zoujq/1025--/电路/电路设计.docx

耀贵电子-风扇

引脚 | 功能 | 分配 | 备注注意事项
1 | TK15/P1.7 | TOUCH1 | 开关
2 | TK14/P1.6 | TOUCH2 | 风速
3 | TK13/P1.5 | TOUCH3 | 摇头
4 | TK12/P1.4 | TOUCH4 | 定时
5 | TK11/P1.3 | DW1 | 可控硅1挡驱动
6 | TK10/P1.2 | DW2 | 可控硅2挡驱动
7 | TK9/P1.1 | DW3 | 可控硅3挡驱动
8 | Vref/AN7/P0.7 | YAOTOU | 可控硅摇头驱动
9 | GND
10 | VDD
11 | P0.3/AN3/TK3 | UART_RX | wifi RX
12 | P0.2/AN2/TK2 | UART_TX | wifi TX
13 | P0.1/AN1/TK1/INT1 | C | 数码管
14 | P0.0/AN0/TK0/INT0/FLT0 | D | 数码管
15 | P2.7/AN15 | E | 数码管
16 | P2.6/AN14 | F | 数码管
17 | P2.5/AN13 | G | 数码管
18 | P2.4/AN12/RST | BUZZ
19 | P3.5/INT17 | NEC_R | 红外接收
20 | P3.4/INT16 | COM1 | 数码管
21 | P2.3/AN11 | COM2 | 数码管
22 | P2.2/AN10/SCK | TOUCH_LED_COM | 触摸灯
23 | P2.1/AN9 | A | 数码管
24 | P2.0/NA8/SDA | B | 数码管
