zoujq/1025--/电路/1025-风扇/1025-风扇BOM.xls

Comment | Description | Designator | Footprint | Quantity | Value
Cap | Polarized Capacitor (Radial) | C2, C3 | CAE8-3.05 | 2 | 2.2uF/400V
Cap | Capacitor | C5 | C 1206_M | 1 | 10uF
Cap | Polarized Capacitor (Radial) | C6 | CAE8-3.05 | 1 | 470uF/16V
Cap | Capacitor | C10 | C 0805_L | 1 | 10uF
Cap | Capacitor | C11 | C 0603_L | 1 | 0.1uF
安规电容 | 安规Capacitor | CX1 | CX2-13*5-10 | 1 | 0.22uF
M7 | 整流二极管 | D1, D2 | D3528 | 2
ES1J | 快速二极管 | D3 | D3528 | 1
LED0 | Typical INFRARED GaAs LED | D10, D11, D12, D13 | LED 0805W | 4
Fuse 1 | Fuse | F2 | FUSE15 | 1
TOUCH | 触摸弹簧 | KEY1, KEY2, KEY3, KEY4 | KEY-T9-2 | 4
Inductor | Inductor | L1 | L15 | 1 | 1mH
Inductor | Inductor | L2 | L3 | 1 | 1mH
Speaker | Loudspeaker | LS1 | BEEP 4x9x5.5 | 1
JSI838 | 红外接收器 | NEC2 | HS0038B | 1
220V~ | Header, 2-Pin | P00 | VH-3AW | 1
档位接口 | Header, 4-Pin | P01 | XH-4AW | 1
主板电源接口 | Header, 6-Pin | P50 | HDR1.27-LI-6P | 1
电源板电源接口 | Header, 6-Pin | P51 | HDR1.27-M-LI-6P | 1
HST97A8 | Silicon Bidirectional Triode Thyristor | Q1, Q2, Q3, Q4 | SOT-89 | 4
10D471 | Varistor (Voltage-Sensitive Resistor) | R1 | ZNR7.5 | 1
Res2 | Resistor | R2 | R 1206-HP_M | 1 | 24K
Res2 | Resistor | R3 | R 1206-HP_M | 1 | 1K
Res2 | Resistor | R6 | R 1206-HP_M | 1 | 22K
Res2 | Resistor | R8 | R 1206-HP_M | 1 | 510K
Res2 | Resistor | R10, R11, R12, R13, R14, R15, R16 | R 0603_L | 7 | 201
Res2 | Resistor | R20, R21, R22, R23 | R 1206-HP_M | 4 | 561
Res2 | Resistor | R30 | R 0603_L | 1 | 1K
Res2 | Resistor | R50 | R 0603_L | 1 | 4.7K
3621A | 0.36寸2位共阴数码管 | SMG1 | SMG 0.36-2P | 1
YX23F01CB_24 | 主控MCU | U1 | SOP24_M | 1
LP2601 | 5V隔离电源 | U3 | SOT23-6L | 1
