zoujq/1025--/(list of files, cad)

Other CAD files:
软件/YX23F01CB_Touch_Library_Code V1.0.5.0/Project/UV5/Output/Main.obj
软件/YX23F01CB_Touch_Library_Code V1.0.5.0/Project/UV5/Output/YX23F01CB_IO_INIT.obj
软件/YX23F01CB_Touch_Library_Code V1.0.5.0/Project/UV5/Output/YX23F01CB_TouchUartDebug_Lib_CFG.obj
软件/YX23F01CB_Touch_Library_Code V1.0.5.0/Project/UV5/Output/YX23F01CB_GeneralKey_Touch_Multibutton.obj
软件/YX23F01CB_Touch_Library_Code V1.0.5.0/Project/UV5/Output/YX23F01CB_GeneralKey_Touch_Lib_CFG.obj
软件/YX23F01CB_Touch_Library_Code V1.0.5.0/Project/UV5/Output/YX23F01CB_GeneralKey_Touch_Filter.obj
软件/YX23F01CB_Touch_Library_Code V1.0.5.0/Project/UV5/Output/YX23F01CB_ISR.obj
软件/YX23F01CB_Touch_Library_Code V1.0.5.0/Project/UV5/Output/YX23F01CB_SYS.obj
软件/YX23F01CB_Touch_Library_Code V1.0.5.0/Project/UV5/Output/YX23F01CB_PORT_MAP.obj
软件/YX23F01CB_Touch_Library_Code V1.0.5.0/Project/UV5/Output/STARTUP.obj
软件/YX23F01CB_Touch_Library_Code V1.0.5.0/Project/UV5/Output/printf.obj
软件/YX23F01CB_Touch_Library_Code V1.0.5.0/Project/UV5/Output/printf_c.obj
软件/YX23F01CB_Touch_Library_Code V1.0.5.0/Project/UV5/Output/delay.obj
