zoujq/1025--/1025-风扇原理图.pdf

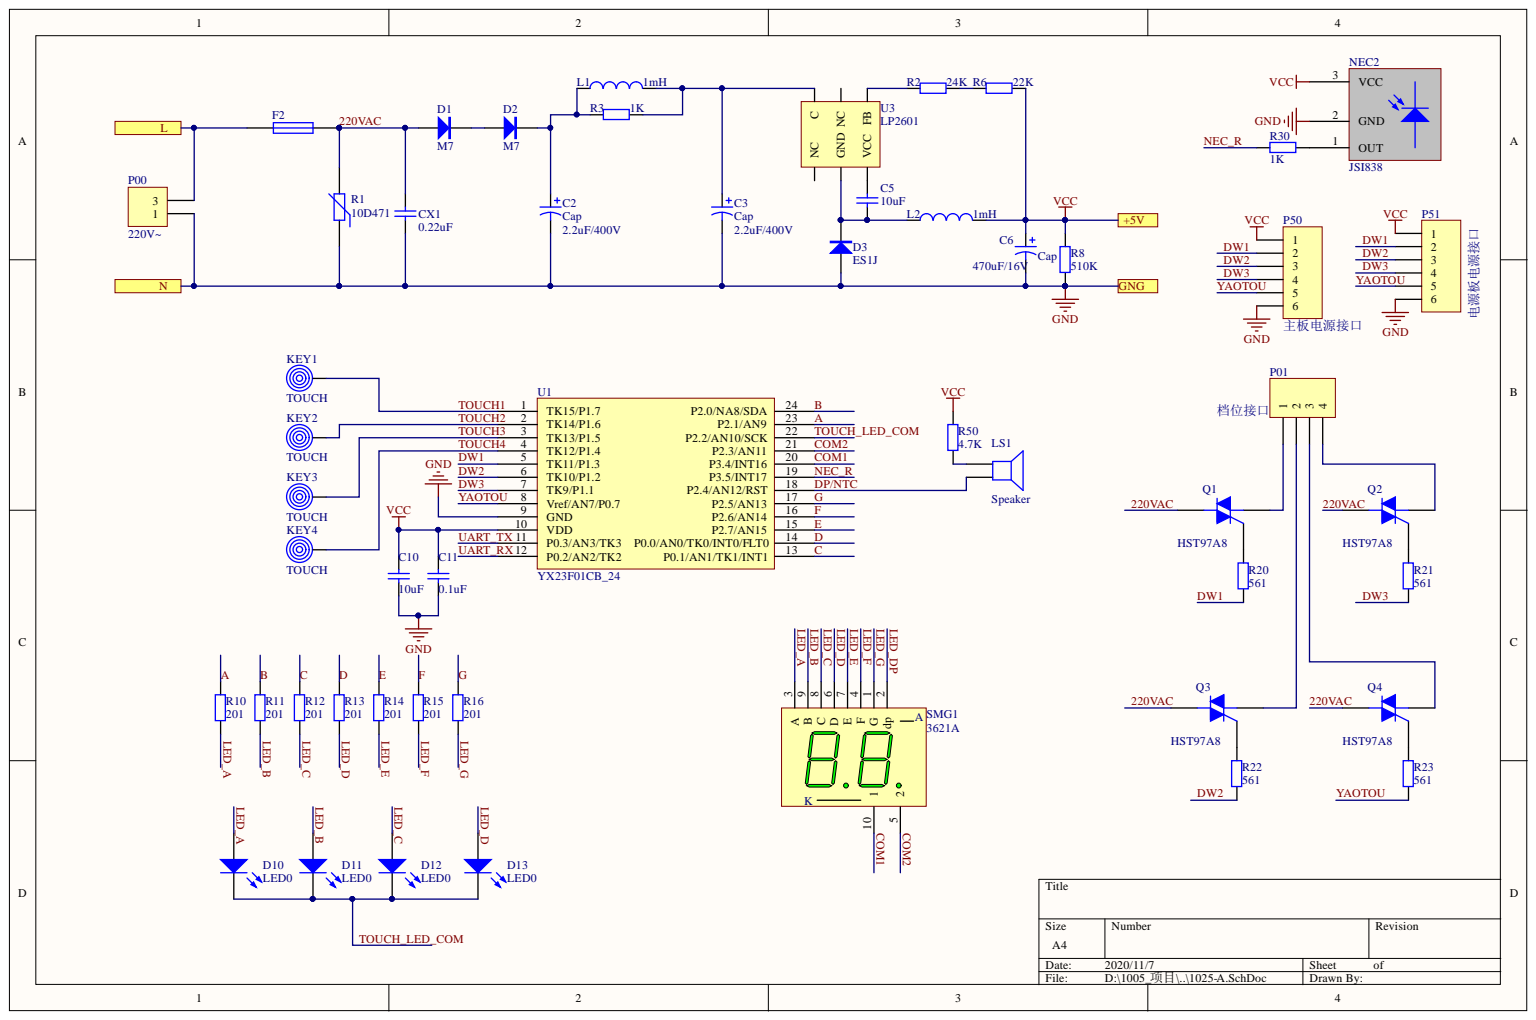
[picture p1: page 1]

TOUCH3 | TK13/P1.5 3
TOUCH4 | TK12/P1.4 4
DW1 GND | TK11/P1.3 5

UART_TX | P0.3/AN3/TK3 11

C10 | UART_RX
