zoujq/1025--/(list of files, drawings)

Other design files:
SD-FS-XMK01D.PcbDoc
SD-FS-XMK01P.PcbDoc
电路/1025-风扇/1025-A.SchDoc
电路/1025-风扇/1025-one-2.PcbDoc
电路/1025-风扇/1025-one.PcbDoc
电路/1025-风扇/1025-风扇.PrjPcb
电路/1025-风扇/1025.SchLib
电路/1025-风扇/1025_power.PcbDoc
电路/最新/SD-FS-XMK01D-(20201205).PcbDoc
跃贵LP2601 - Copy.PcbDoc
跃贵LP2601.PcbDoc
